robertheeter/optogenetic-box/experiment/images/dark_dish.jpg

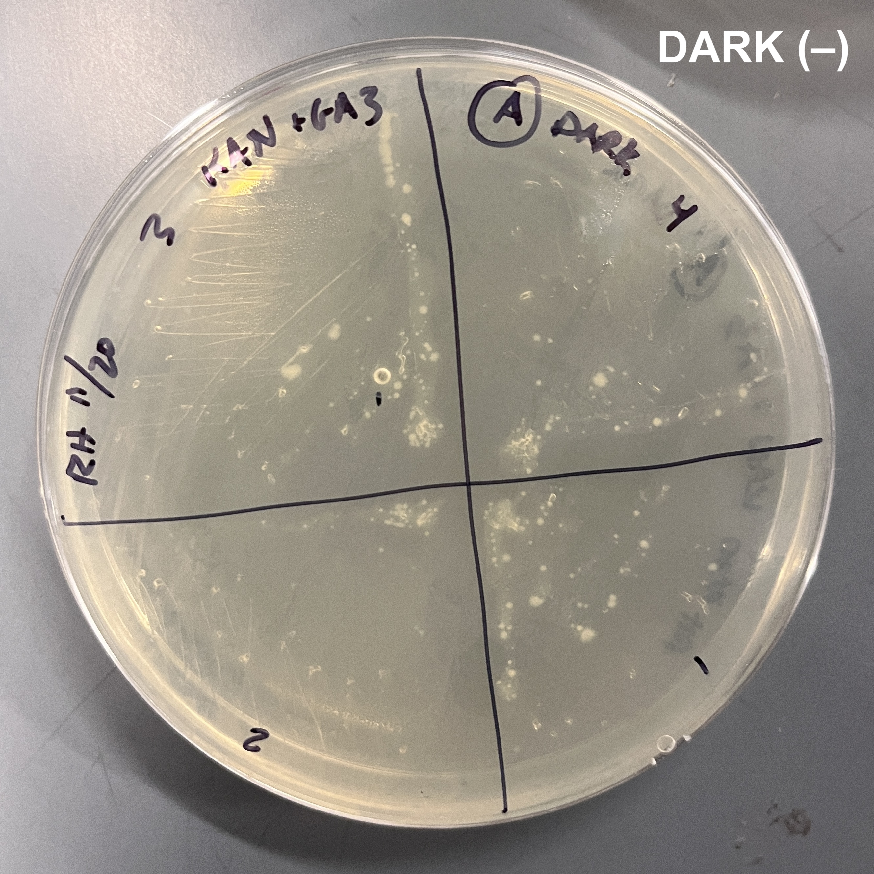
experiment/images/dark_dish.jpg
