robertheeter/optogenetic-box/experiment/images/light_dish.jpg

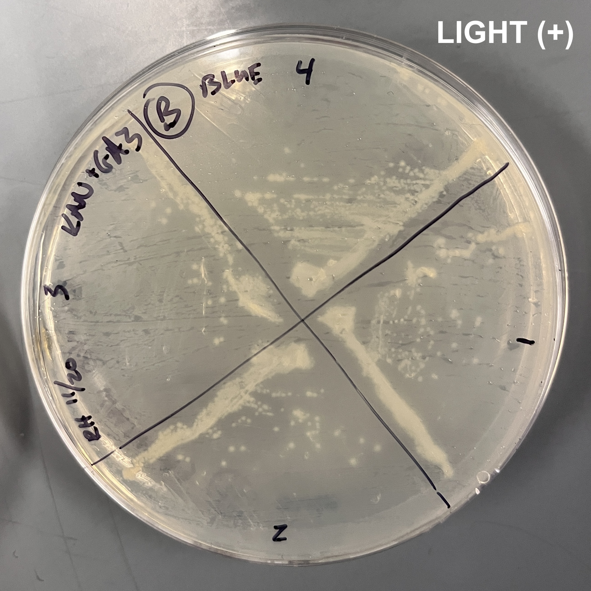
experiment/images/light_dish.jpg
