robertheeter/optogenetic-box/README.md

# optogenetic-box
Supporting material for a 3D-printed 24-well plate optogenetic stimulation system. Completed Fall 2024 at Princeton University.
