robertheeter/optogenetic-box/fabrication/cad/1_base.stl

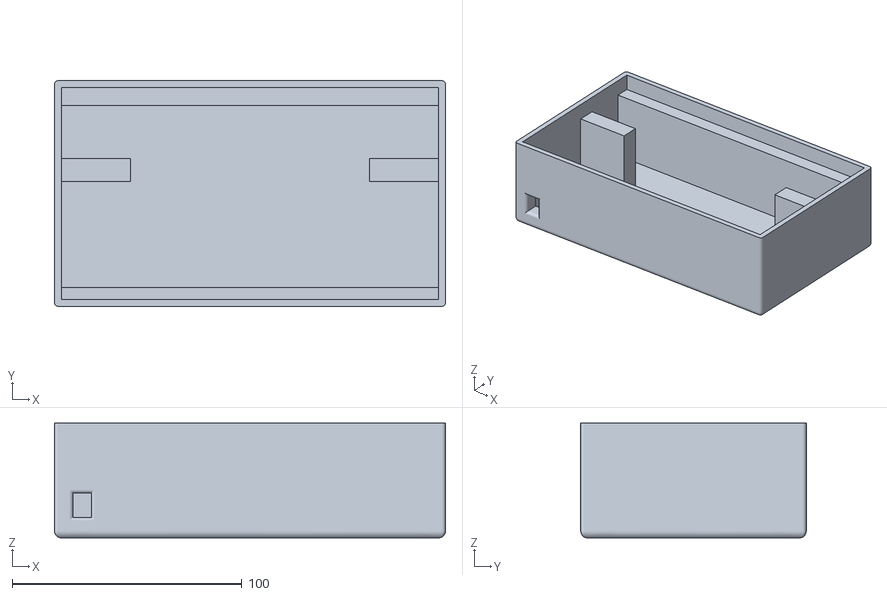
[picture p8: CAD file, 2024-12-13]
fabrication/cad/1_base.stl
170.2 x 98.2 x 50.0
