robertheeter/optogenetic-box/fabrication/cad/4_lid.stl

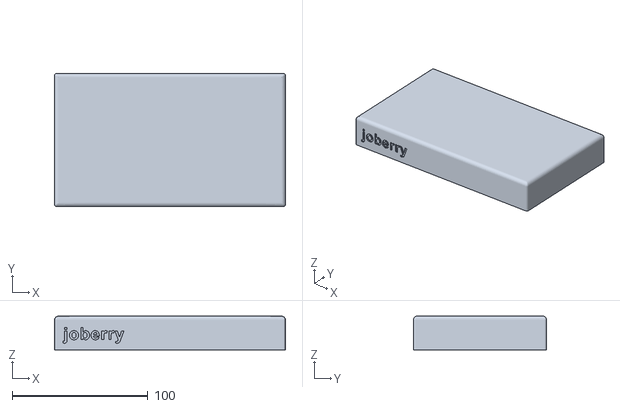
[picture p9: CAD file, 2024-12-13]
fabrication/cad/4_lid.stl
170.2 x 98.2 x 25.0
