robertheeter/optogenetic-box/fabrication/cad/3_plate_frame.stl

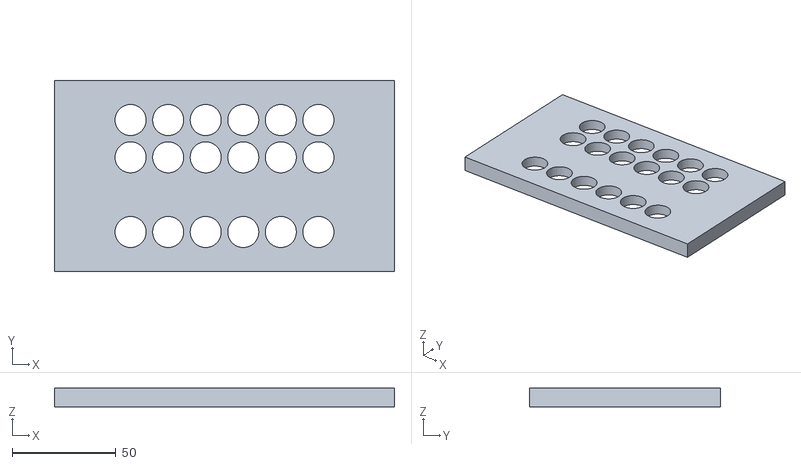
[picture p10: CAD file, 2024-12-13]
fabrication/cad/3_plate_frame.stl
164.0 x 92.0 x 9.00
