robertheeter/optogenetic-box/fabrication/cad/2_light_frame.stl

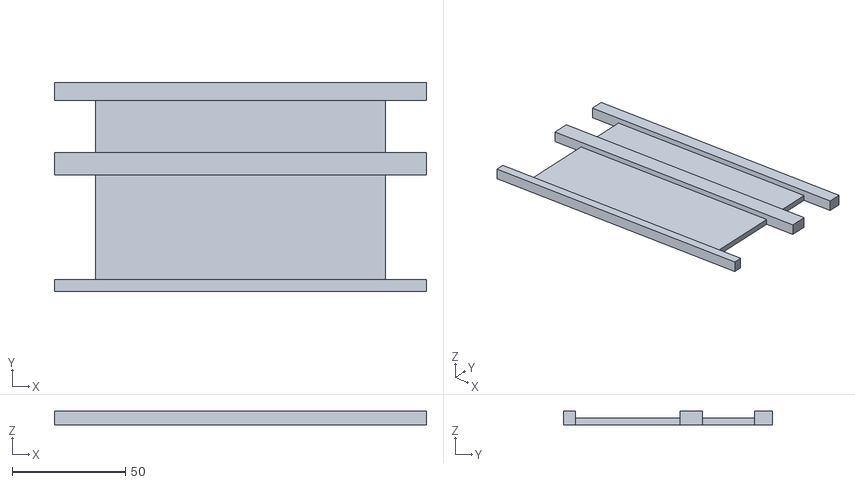
[picture p11: CAD file, 2024-12-13]
fabrication/cad/2_light_frame.stl
164.0 x 92.0 x 6.00
