robertheeter/optogenetic-box/fabrication/renderings/assembly.png

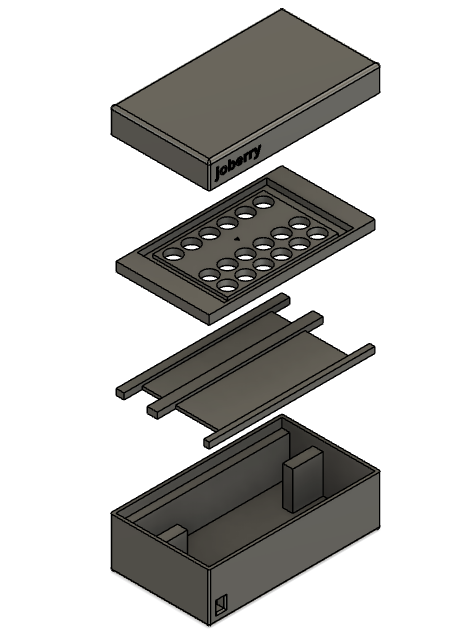
fabrication/renderings/assembly.png
