robertheeter/optogenetic-box/fabrication/renderings/box.png

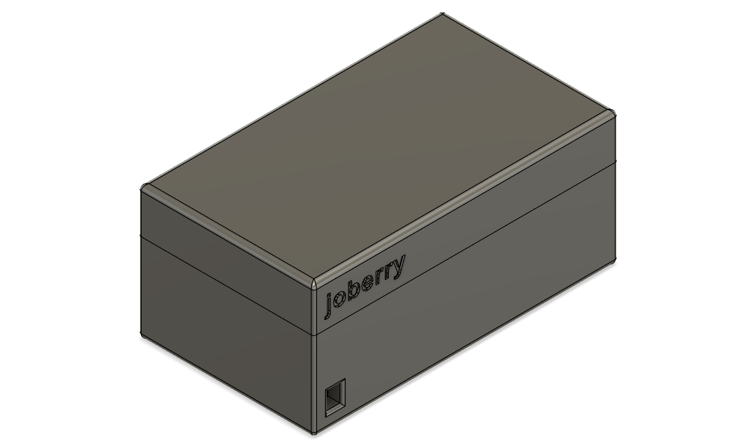
fabrication/renderings/box.png
