robertheeter/optogenetic-box/fabrication/renderings/cross_section.png

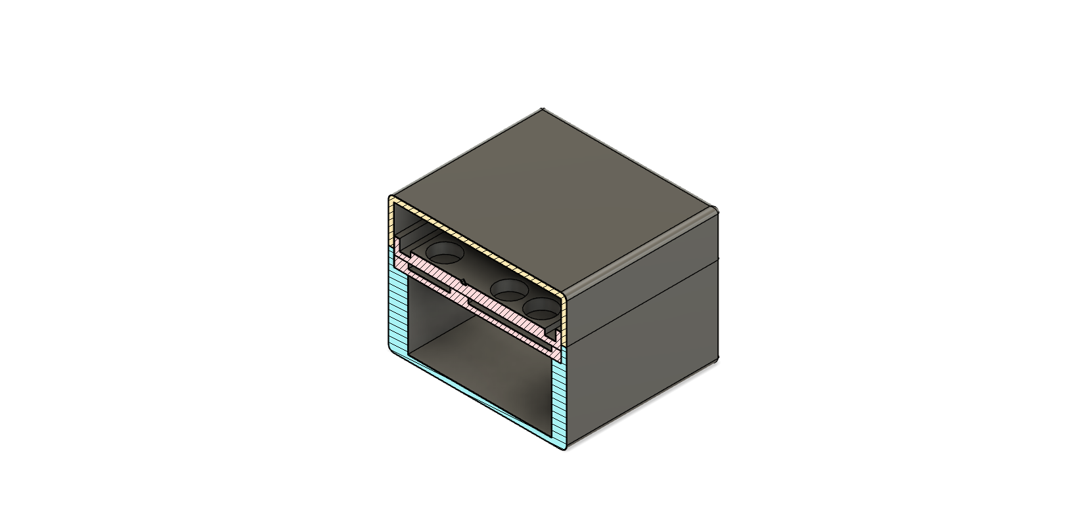
fabrication/renderings/cross_section.png
