robertheeter/optogenetic-box/experiment/data/results.xlsx

Sheet: Kathryn+Aileen
Application: Tecan i-control |  |  |  | Tecan i-control , 2.0.10.0
Device: infinite 200Pro |  |  |  | Serial number: 2104003109 |  |  | Serial number of connected stacker:
Firmware: V_4.31_06/19_Infinite (Jun 30 2019/17.59.51) |  |  |  | MAI, V_4.31_06/19_Infinite (Jun 30 2019/17.59.51)
Date: | 2024-12-03
Time: | 9:24:08 PM
System |  |  |  | CBE-JLA-13
User |  |  |  | PRINCETON\cp-cbe-jla
Plate |  |  |  | Greiner 24 Flat Bottom Transparent Polystyrene Cat. No.: 662102/662160 [GRE24ft.pdfx]
Plate-ID (Stacker)
Movement |  |  |  | Move Plate In
Shaking (Orbital) Duration: |  |  |  | 10 | s
Shaking (Orbital) Amplitude: |  |  |  | 3 | mm
Label: Label1
Mode |  |  |  | Absorbance
Measurement Wavelength |  |  |  | 600 | nm
Bandwidth |  |  |  | 10 | nm
Number of Flashes |  |  |  | 25
Settle Time |  |  |  | 0 | ms
Start Time: | 12/3/2024 9:24:19 PM
 | Temperature: 21 °C
<> | 1 | 2 | 3 | 4 | 5 | 6
A | 0.1058000028 | 0.04289999977 | 0.07349999994 | 0.04030000046 | 0.06159999967 | 0.06069999933
B | 0.07240000367 | 0.04549999908 | 0.1155999973 | 0.03889999911 | 0.1905000061 | 0.0458999984
C | 0.0848999992 | 0.08600000292 | 0.2417999953 | 0.059799999 | 0.1544999927 | 0.1022000015
D | 0.03709999844 | 0.04419999942 | 0.04270000011 | 0.03570000082 | 0.0577000007 | 0.03550000116
End Time: | 12/3/2024 9:24:45 PM
Movement |  |  |  | Move Plate Out

Sheet: Milosz+Adham
Application: Tecan i-control |  |  |  | Tecan i-control , 2.0.10.0
Device: infinite 200Pro |  |  |  | Serial number: 2104003109 |  |  | Serial number of connected stacker:
Firmware: V_4.31_06/19_Infinite (Jun 30 2019/17.59.51) |  |  |  | MAI, V_4.31_06/19_Infinite (Jun 30 2019/17.59.51)
Date: | 2024-12-03
Time: | 9:22:56 PM
System |  |  |  | CBE-JLA-13
User |  |  |  | PRINCETON\cp-cbe-jla
Plate |  |  |  | Greiner 24 Flat Bottom Transparent Polystyrene Cat. No.: 662102/662160 [GRE24ft.pdfx]
Plate-ID (Stacker)
Movement |  |  |  | Move Plate In
Shaking (Orbital) Duration: |  |  |  | 10 | s
Shaking (Orbital) Amplitude: |  |  |  | 3 | mm
Label: Label1
Mode |  |  |  | Absorbance
Measurement Wavelength |  |  |  | 600 | nm
Bandwidth |  |  |  | 10 | nm
Number of Flashes |  |  |  | 25
Settle Time |  |  |  | 0 | ms
Start Time: | 12/3/2024 9:23:07 PM
 | Temperature: 21 °C
<> | 1 | 2 | 3 | 4 | 5 | 6
A | 0.1941999942 | 0.1780000031 | 0.2047999948 | 0.513100028 | 0.4665000141 | 0.519200027
B | 0.4832000136 | 0.5041999817 | 0.5181999803 | 0.2170999944 | 0.2046999931 | 0.2045000046
C | 0.6536999941 | 0.5960000157 | 0.6042000055 | 0.1879000068 | 0.1852999926 | 0.1951999962
D | 0.4762000144 | 0.4837000072 | 0.5329999924 | 0.4460000098 | 0.442900002 | 0.462199986
End Time: | 12/3/2024 9:23:32 PM
Movement |  |  |  | Move Plate Out

Sheet: Rober+Jerry2
Application: Tecan i-control |  |  |  | Tecan i-control , 2.0.10.0
Device: infinite 200Pro |  |  |  | Serial number: 2104003109 |  |  | Serial number of connected stacker:
Firmware: V_4.31_06/19_Infinite (Jun 30 2019/17.59.51) |  |  |  | MAI, V_4.31_06/19_Infinite (Jun 30 2019/17.59.51)
Date: | 2024-12-03
Time: | 9:21:40 PM
System |  |  |  | CBE-JLA-13
User |  |  |  | PRINCETON\cp-cbe-jla
Plate |  |  |  | Greiner 24 Flat Bottom Transparent Polystyrene Cat. No.: 662102/662160 [GRE24ft.pdfx]
Plate-ID (Stacker)
Movement |  |  |  | Move Plate In
Shaking (Orbital) Duration: |  |  |  | 10 | s
Shaking (Orbital) Amplitude: |  |  |  | 3 | mm
Label: Label1
Mode |  |  |  | Absorbance
Measurement Wavelength |  |  |  | 600 | nm
Bandwidth |  |  |  | 10 | nm
Number of Flashes |  |  |  | 25
Settle Time |  |  |  | 0 | ms
Start Time: | 12/3/2024 9:21:51 PM
 | Temperature: 21 °C
<> | 1 | 2 | 3 | 4 | 5 | 6
A | 0.605799973 | 0.6119999886 | 0.6345000267 | 0.3470999897 | 0.3177999854 | 0.3546999991
B | 0.2980999947 | 0.3106000125 | 0.3621000051 | 0.353700012 | 0.358799994 | 0.3880999982
C | 0.1873999983 | 0.1951999962 | 0.2034000009 | 0.203700006 | 0.2011999935 | 0.2215999961
D | 0.1893000007 | 0.1932999939 | 0.2352000028 | 0.33919999 | 0.3585999906 | 0.3815000057
End Time: | 12/3/2024 9:22:17 PM
Movement |  |  |  | Move Plate Out

Sheet: Grecia+Paul
Application: Tecan i-control |  |  |  | Tecan i-control , 2.0.10.0
Device: infinite 200Pro |  |  |  | Serial number: 2104003109 |  |  | Serial number of connected stacker:
Firmware: V_4.31_06/19_Infinite (Jun 30 2019/17.59.51) |  |  |  | MAI, V_4.31_06/19_Infinite (Jun 30 2019/17.59.51)
Date: | 2024-12-03
Time: | 9:20:32 PM
System |  |  |  | CBE-JLA-13
User |  |  |  | PRINCETON\cp-cbe-jla
Plate |  |  |  | Greiner 24 Flat Bottom Transparent Polystyrene Cat. No.: 662102/662160 [GRE24ft.pdfx]
Plate-ID (Stacker)
Movement |  |  |  | Move Plate In
Shaking (Orbital) Duration: |  |  |  | 10 | s
Shaking (Orbital) Amplitude: |  |  |  | 3 | mm
Label: Label1
Mode |  |  |  | Absorbance
Measurement Wavelength |  |  |  | 600 | nm
Bandwidth |  |  |  | 10 | nm
Number of Flashes |  |  |  | 25
Settle Time |  |  |  | 0 | ms
Start Time: | 12/3/2024 9:20:43 PM
 | Temperature: 21.1 °C
<> | 1 | 2 | 3 | 4 | 5 | 6
A | 0.4923000038 | 0.4769000113 | 0.5067999959 | 0.2540000081 | 0.2390999943 | 0.2587000132
B | 0.5673999786 | 0.5630999804 | 0.5812000036 | 0.2134000063 | 0.2169000059 | 0.231099993
C | 0.1888000071 | 0.1794999987 | 0.192900002 | 0.1733999997 | 0.1729000062 | 0.06740000099
D | 0.3792000115 | 0.3639000058 | 0.4140999913 | 0.1781000048 | 0.1671999991 | 0.1659999937
End Time: | 12/3/2024 9:21:09 PM
Movement |  |  |  | Move Plate Out

Sheet: robert+Jerry
Application: Tecan i-control |  |  |  | Tecan i-control , 2.0.10.0
Device: infinite 200Pro |  |  |  | Serial number: 2104003109 |  |  | Serial number of connected stacker:
Firmware: V_4.31_06/19_Infinite (Jun 30 2019/17.59.51) |  |  |  | MAI, V_4.31_06/19_Infinite (Jun 30 2019/17.59.51)
Date: | 2024-12-03
Time: | 8:05:18 PM
System |  |  |  | CBE-JLA-13
User |  |  |  | PRINCETON\cp-cbe-jla
Plate |  |  |  | Greiner 24 Flat Bottom Transparent Polystyrene Cat. No.: 662102/662160 [GRE24ft.pdfx]
Plate-ID (Stacker)
Movement |  |  |  | Move Plate In
Shaking (Orbital) Duration: |  |  |  | 10 | s
Shaking (Orbital) Amplitude: |  |  |  | 3 | mm
Label: Label1
Mode |  |  |  | Absorbance
Measurement Wavelength |  |  |  | 600 | nm
Bandwidth |  |  |  | 10 | nm
Number of Flashes |  |  |  | 25
Settle Time |  |  |  | 0 | ms
Start Time: | 12/3/2024 8:05:29 PM
 | Temperature: 20.7 °C
<> | 1 | 2 | 3 | 4 | 5 | 6
A | 0.595600009 | 0.5932000279 | 0.6205000281 | 0.3194999993 | 0.2946000099 | 0.3276999891
B | 0.2802000046 | 0.2836999893 | 0.3301999867 | 0.3169000149 | 0.3386000097 | 0.3587000072
C | 0.1796000004 | 0.1845999956 | 0.1907999963 | 0.1923999935 | 0.1933999956 | 0.2120999992
D | 0.1796000004 | 0.1851000041 | 0.2127999961 | 0.3111000061 | 0.3287999928 | 0.3443000019
End Time: | 12/3/2024 8:05:55 PM
Movement |  |  |  | Move Plate Out
