robertheeter/optogenetic-box/experiment/figures/duty_cycle_modulation.png

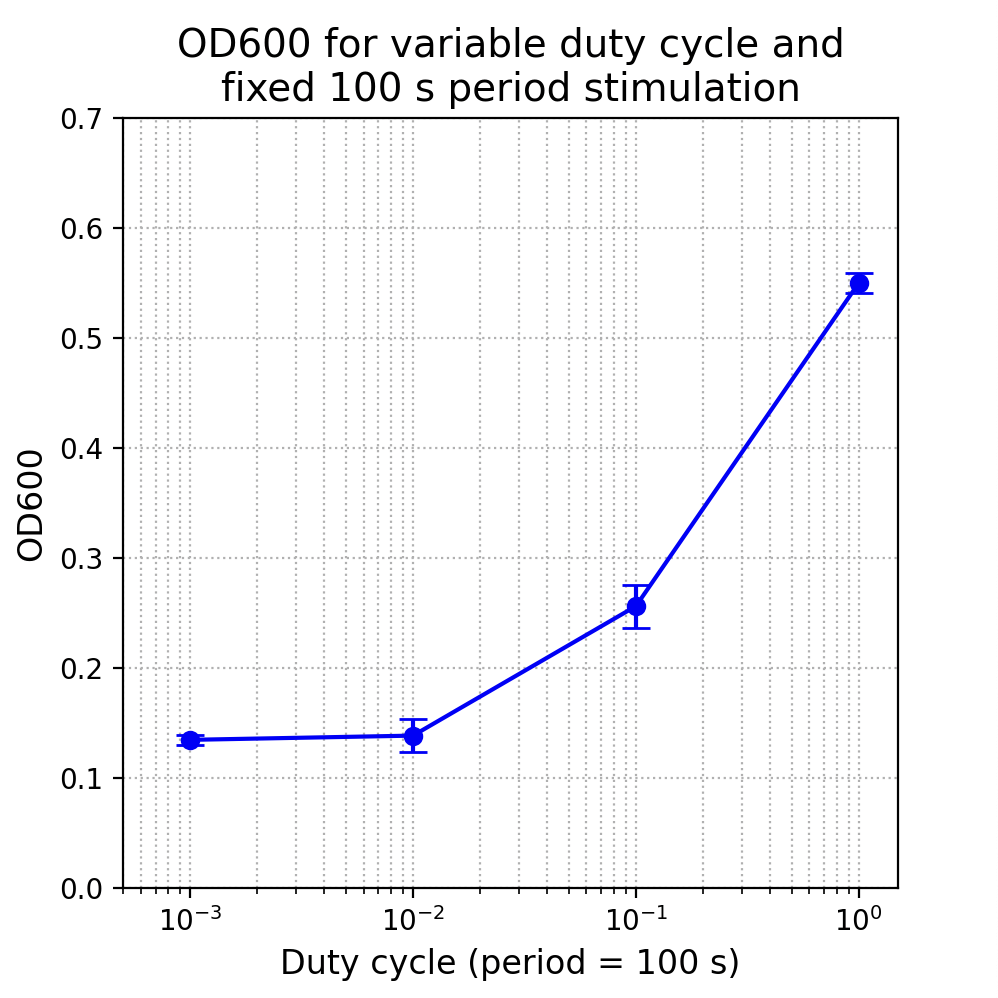
experiment/figures/duty_cycle_modulation.png
