robertheeter/optogenetic-box/experiment/figures/period_modulation.png

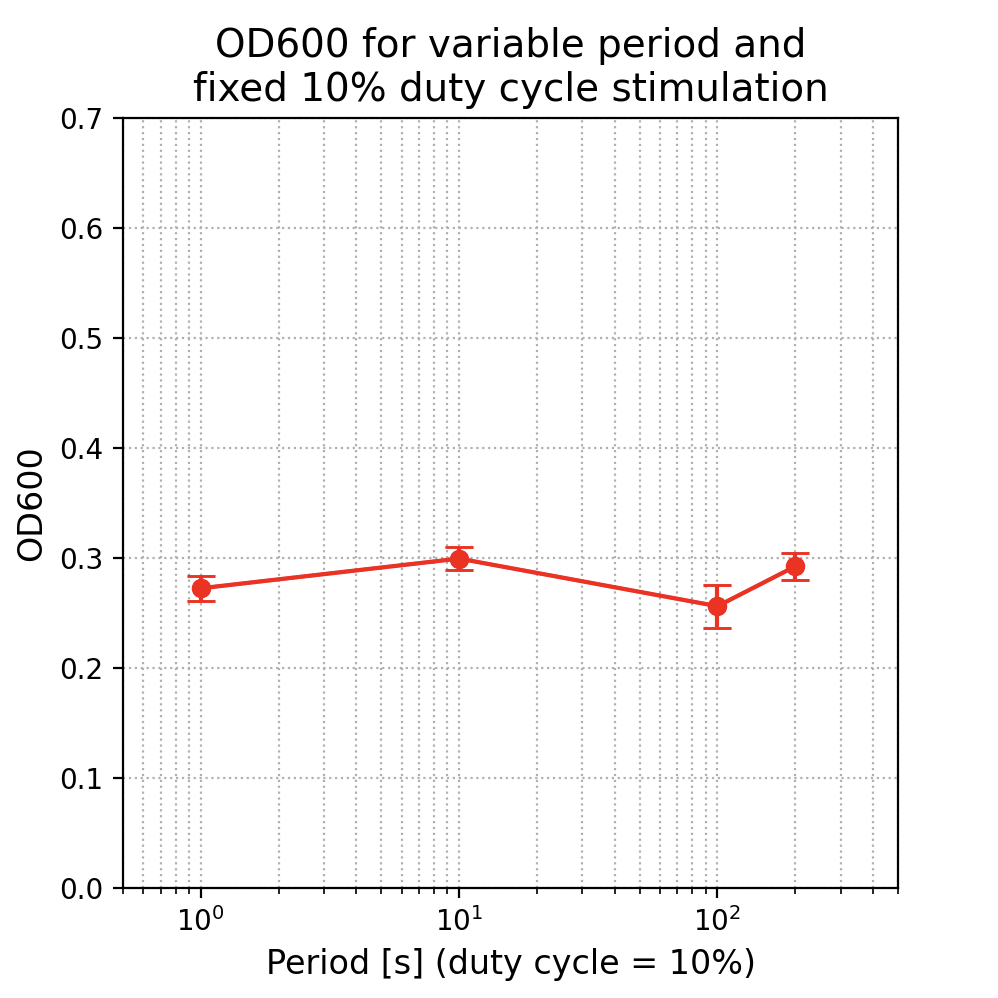
experiment/figures/period_modulation.png
